P1V4/FireExtinguisher/README.md

# FireExtinguisher
The python code to detect the center of fire in the image is in the file precessing_coordinates.py.
The Arduino Code is in motor_mech.ino
The project report is in FireExtinguisher.pdf.
